mupfdev/TrackMAG/docs/TrackMAG_v1_Prototype_03.jpg

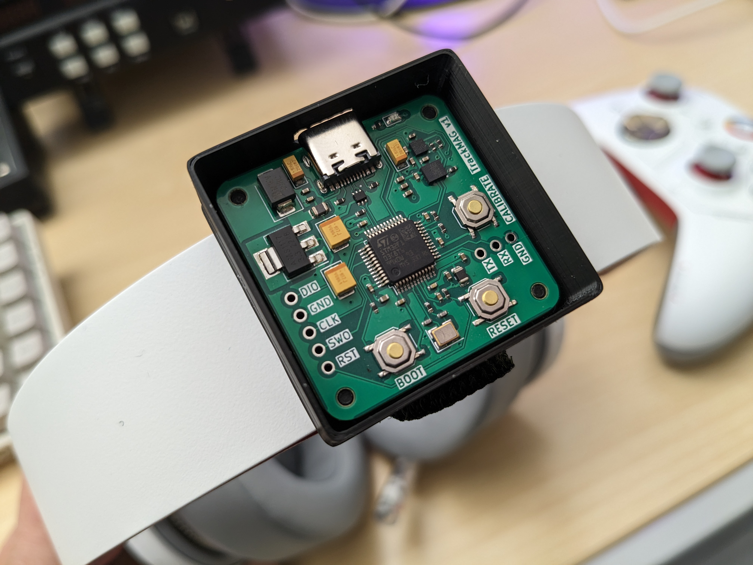
docs/TrackMAG_v1_Prototype_03.jpg
