mupfdev/TrackMAG/docs/TrackMAG_v1_3D.png

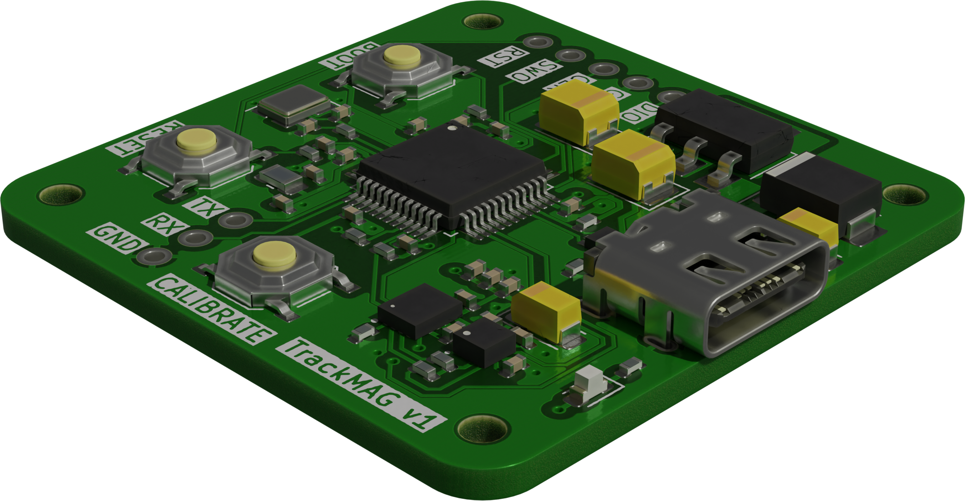
docs/TrackMAG_v1_3D.png
