mupfdev/TrackMAG/docs/serial-oscilloscope.png

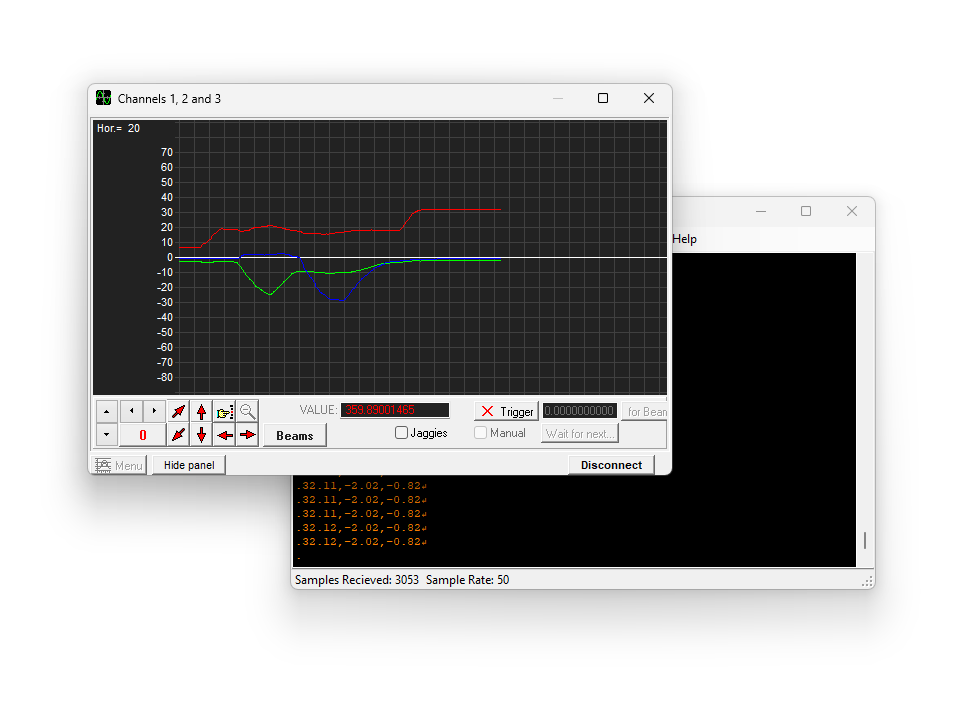
docs/serial-oscilloscope.png
