mupfdev/TrackMAG/docs/TrackMAG_v1_Prototype_01.jpg

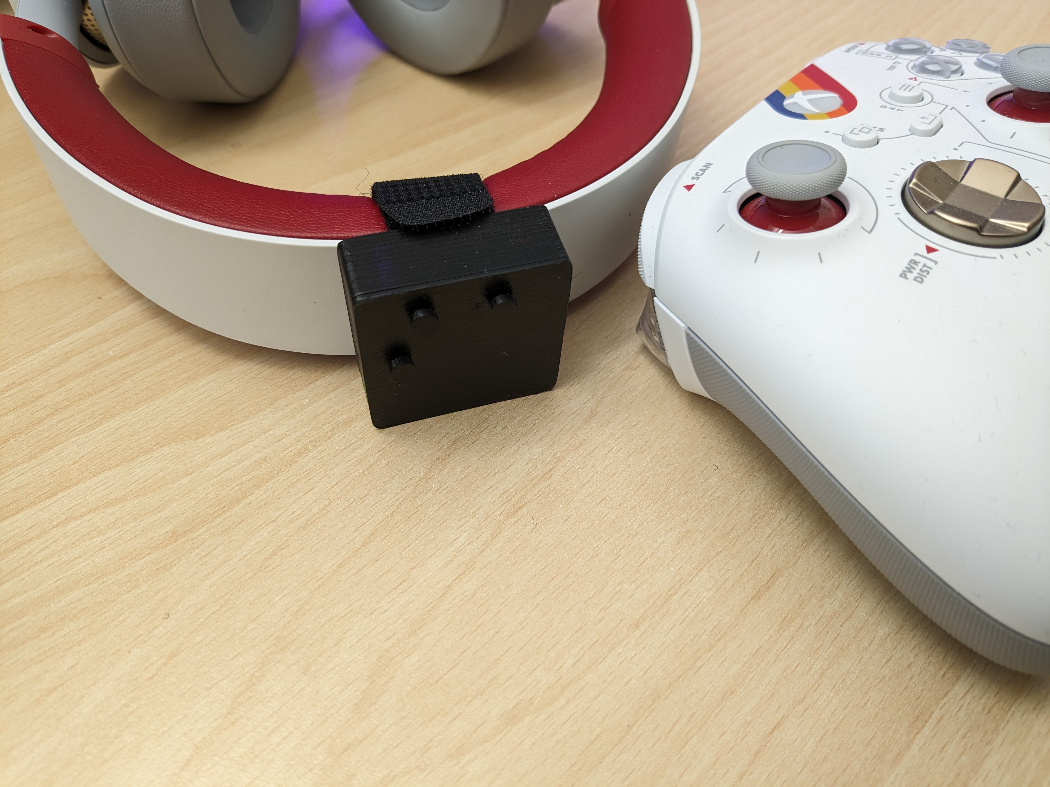
docs/TrackMAG_v1_Prototype_01.jpg
