mupfdev/TrackMAG/docs/TrackMAG_v1_Prototype_02.jpg

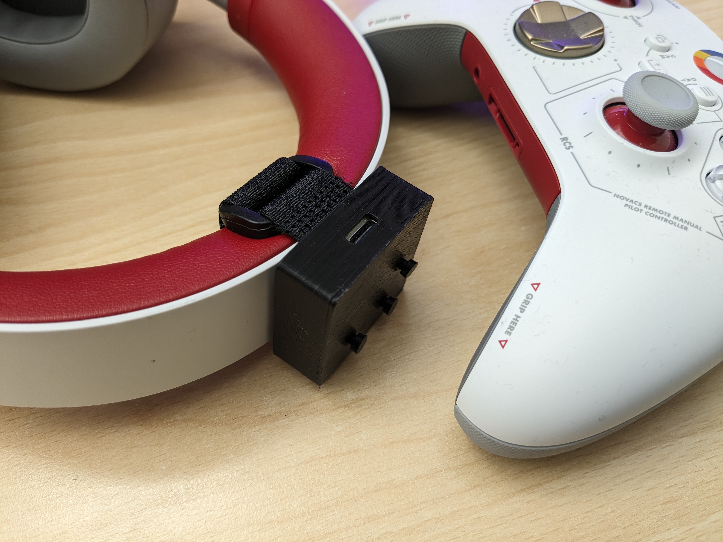
docs/TrackMAG_v1_Prototype_02.jpg
