mupfdev/TrackMAG/cad/TrackMAG_v1_Case.FCStd

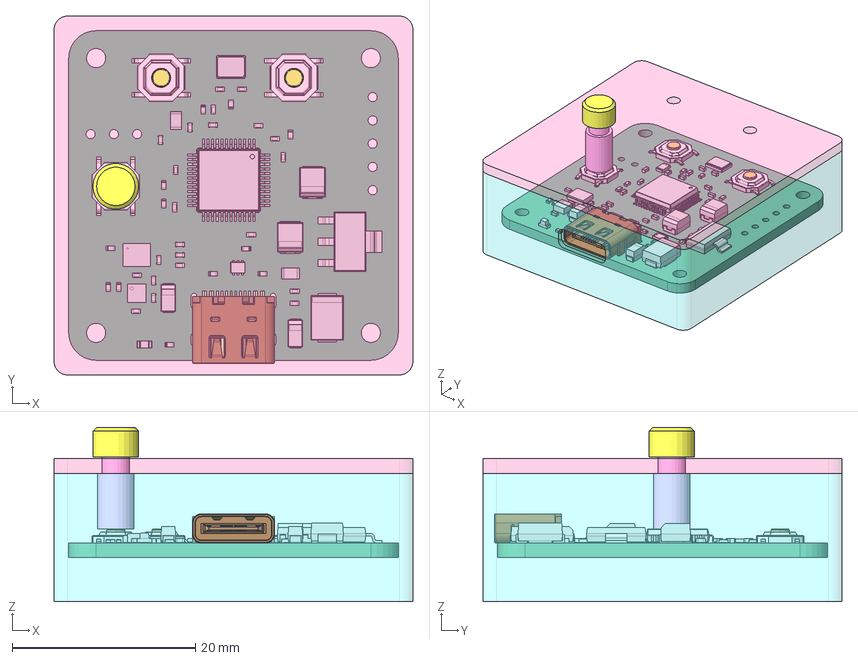
[picture p6: CAD file, 2023-10-26]
cad/TrackMAG_v1_Case.FCStd
39.2 x 39.2 x 19.0 mm
Pcb_d3d2
C5_C_0402_1005Metric_9a69e1afbfc4
U2_SOT_666_c43711e0865f
Y1_Crystal_SMD_3225-4Pin_3.2x2.5mm_c5e00f3d7473
R6_R_0402_1005Metric_10b8d5d8e81b
C4_C_0402_1005Metric_6f371c34e9a7
SW-SMD_4P-L5.2-W5.2-H1.5-LS6.4-P3.071
SW-SMD_4P-L5.2-W5.2-H1.5-LS6.4-P3.70
SW-SMD_4P-L5.2-W5.2-H1.5-LS6.4-P3.072
SW-SMD_4P-L5.2-W5.2-H1.5-LS6.4-P3.073
SW-SMD_4P-L5.2-W5.2-H1.5-LS6.4-P3.074
SW-SMD_4P-L5.2-W5.2-H1.5-LS6.4-P3.075
SW-SMD_4P-L5.2-W5.2-H1.5-LS6.4-P3.076
SW-SMD_4P-L5.2-W5.2-H1.5-LS6.4-P3.077
C24_C_0402_1005Metric_25848f3d0c58
FB2_R_0805_2012Metric_17915c3d4c20
C21_C_0402_1005Metric_c99b34758c5f
C7_C_0402_1005Metric_9be6bc2ca55f
C18_CP_EIA_3216_18_Kemet_A_433f65eda25f
SW-SMD_4P-L5.2-W5.2-H1.5-LS6.4-P3.091
SW-SMD_4P-L5.2-W5.2-H1.5-LS6.4-P3.092
SW-SMD_4P-L5.2-W5.2-H1.5-LS6.4-P3.093
SW-SMD_4P-L5.2-W5.2-H1.5-LS6.4-P3.094
SW-SMD_4P-L5.2-W5.2-H1.5-LS6.4-P3.095
SW-SMD_4P-L5.2-W5.2-H1.5-LS6.4-P3.096
SW-SMD_4P-L5.2-W5.2-H1.5-LS6.4-P3.097
SW-SMD_4P-L5.2-W5.2-H1.5-LS6.4-P3.098
U5_SOT_223_951f59756fd7
R11_R_0402_1005Metric_36e4ea1ddef2
SW-SMD_4P-L5.2-W5.2-H1.5-LS6.4-P3.100
SW-SMD_4P-L5.2-W5.2-H1.5-LS6.4-P3.101
SW-SMD_4P-L5.2-W5.2-H1.5-LS6.4-P3.102
SW-SMD_4P-L5.2-W5.2-H1.5-LS6.4-P3.103
SW-SMD_4P-L5.2-W5.2-H1.5-LS6.4-P3.104
SW-SMD_4P-L5.2-W5.2-H1.5-LS6.4-P3.105
SW-SMD_4P-L5.2-W5.2-H1.5-LS6.4-P3.106
SW-SMD_4P-L5.2-W5.2-H1.5-LS6.4-P3.107
D2_D_SMB_b67b8ca27ae9
D1_LED_0603_1608Metric_e1b3c7ec0367
R5_R_0402_1005Metric_749ad747d199
C22_C_0402_1005Metric_51b8da385749
C13_C_0402_1005Metric_0a9d8d8b6256
C26_CP_EIA_3528_21_Kemet_B_90cebfa39647
R2_R_0402_1005Metric_bf39874a3177
C14_C_0402_1005Metric_74524feb4748
C3_C_0402_1005Metric_b7d28959cc93
C16_C_0402_1005Metric_8a28c750fc0c
C12_C_0402_1005Metric_e2d5079fb1e0
C10_C_0402_1005Metric_4719a34ee131
R9_R_0402_1005Metric_5df443b7ed3e
R12_R_0402_1005Metric_7cb5b9999224
R4_R_0402_1005Metric_2e21d4b728d1
R1_R_0402_1005Metric_d8ff90d443a8
C6_C_0402_1005Metric_24ae957f6994
C19_C_0402_1005Metric_59439e0915fe
C8_CP_EIA_3216_18_Kemet_A_7c873c08f671
C15_C_0402_1005Metric_27ff3f71a5b5
R3_R_0402_1005Metric_e49eb8bdb652
C20_C_0402_1005Metric_27a3aa8959b8
C9_C_0402_1005Metric_0a1977d0a397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
