mupfdev/TrackMAG/(threads)

Thread 3 (2023-11-04):

HID-Device not recognised when started via bootloader

mupfdev, 2023-11-04:
This is not a bug of the bootloader. I'm currently investigating the issue.

mupfdev, 2023-11-04:
The problem was a typo in the FLASH offset inside the linker script. The firmware wasn't working at all.

mupfdev, 2023-11-04:
Fixed.

Closed 2023-11-04.
