mupfdev/TrackMAG/pdf/Schematic.pdf

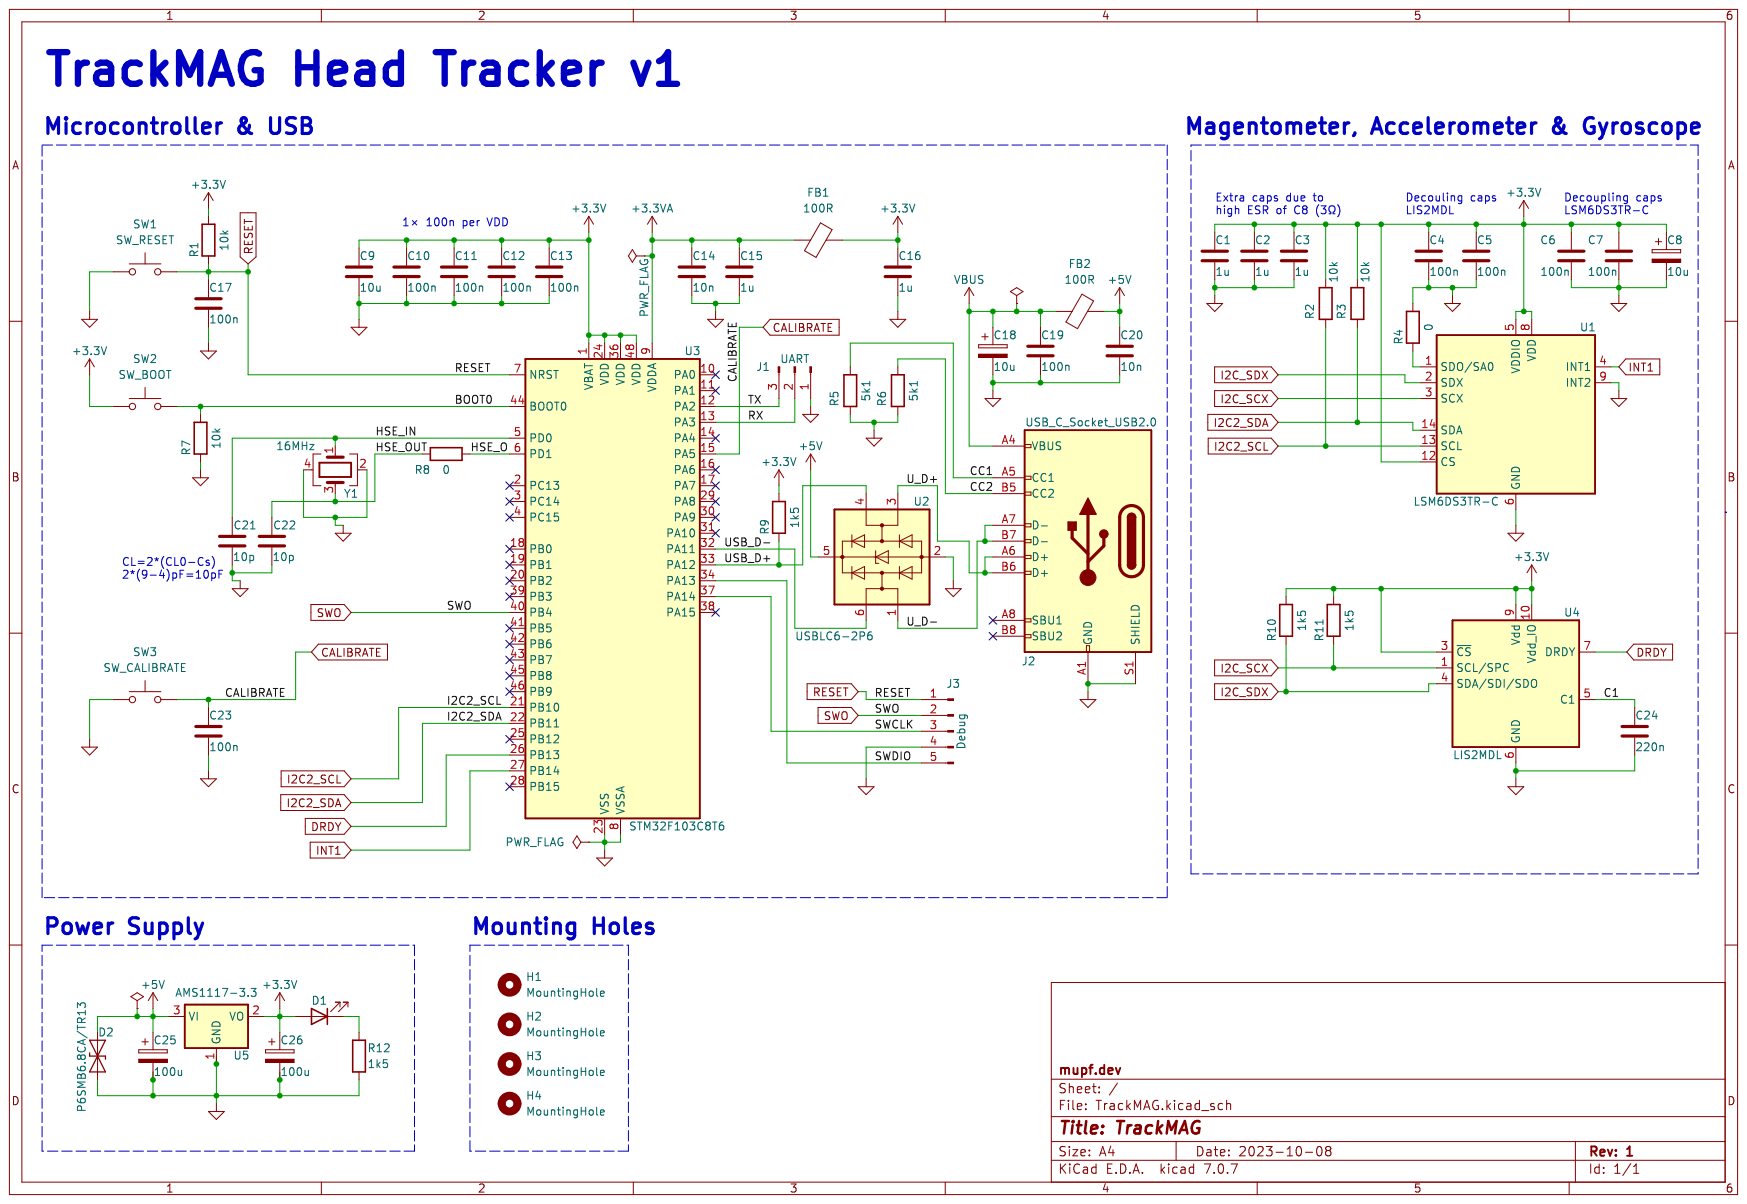
[picture p7: page 1]
