mupfdev/TrackMAG/hardware/TrackMAG.kicad_pcb

## KiCad design hardware/TrackMAG.kicad_pcb (2023-10-11)

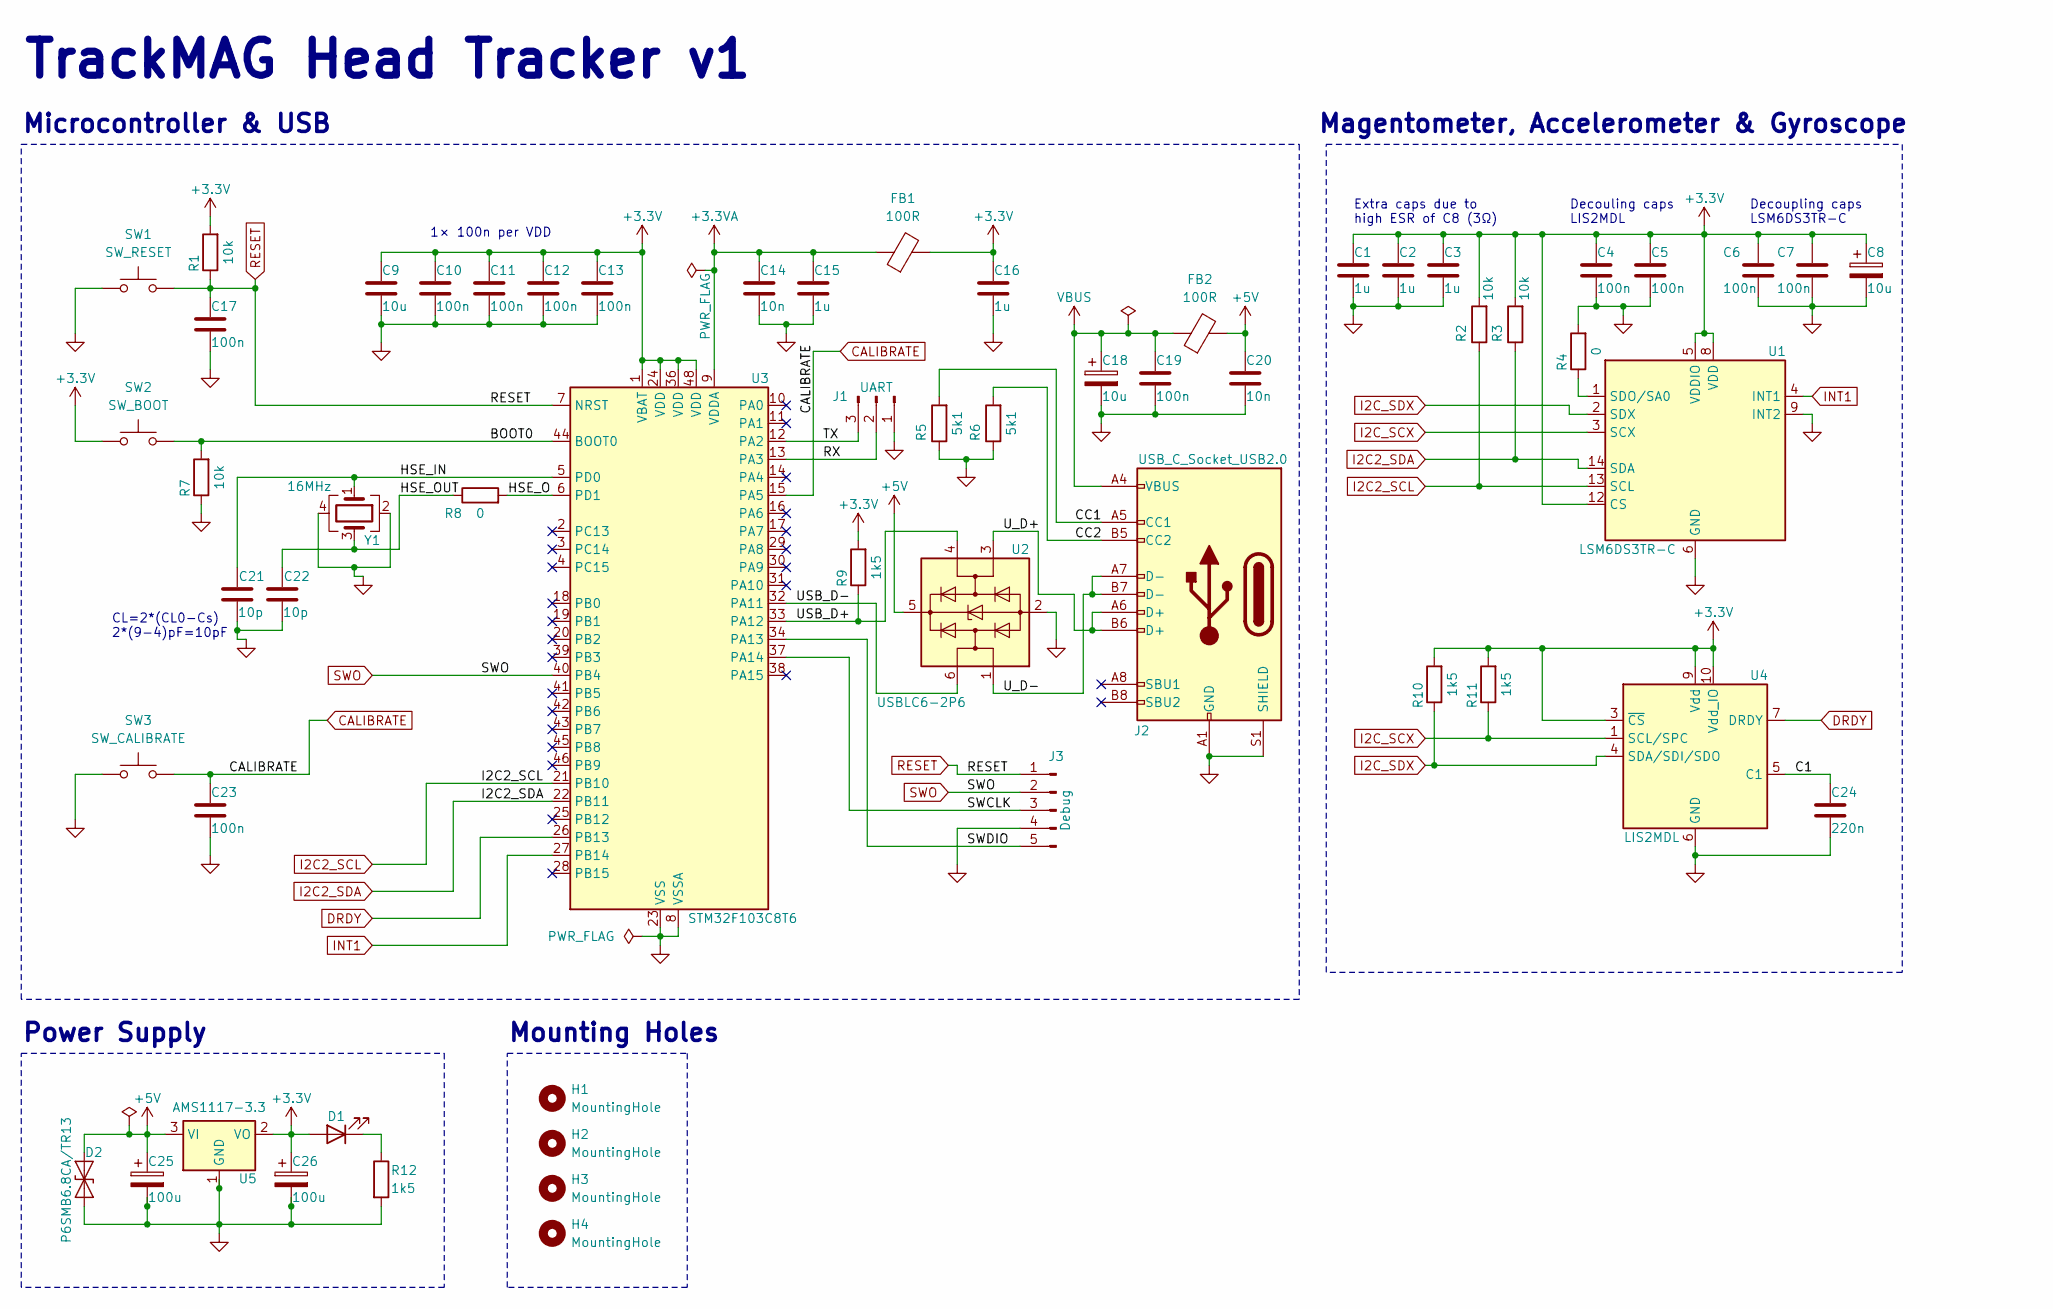
[picture p8: schematic TrackMAG.kicad_sch]

Parts:
C1, C2, C3, C15, C16: 1u; C_0402_1005Metric; JLCPCB Part # C52923
C4, C5, C6, C7, C10, C11, C12, C13, C17, C19, C23: 100n; C_0402_1005Metric; JLCPCB Part # C307331
C8, C18: 10u; CP_EIA-3216-18_Kemet-A; JLCPCB Part # C7171
C9: 10u; C_0402_1005Metric; JLCPCB Part # C15525
C14, C20: 10n; C_0402_1005Metric; JLCPCB Part # C15195
C21, C22: 10p; C_0402_1005Metric; JLCPCB Part # C32949
C24: 220n; C_0402_1005Metric; JLCPCB Part # C16772
C25, C26: 100u; CP_EIA-3528-21_Kemet-B; JLCPCB Part # C16133
D1: LED; LED_0603_1608Metric; JLCPCB Part # C2286
D2: P6SMB6.8CA/TR13; D_SMB; JLCPCB Part # C78395
FB1, FB2: 100R; R_0805_2012Metric; JLCPCB Part # C1015
H1, H2, H3, H4: MountingHole; MountingHole_2.1mm
J1: UART; PinHeader_1x03_P2.54mm_UART
J2: USB_C_Socket_USB2.0; USB_C_Receptacle_G-Switch_GT-USB-7010ASV; JLCPCB Part # C2988369
J3: Debug; PinHeader_1x05_P2.54mm_Debug
R1, R2, R3, R7: 10k; R_0402_1005Metric; JLCPCB Part # C25744
R4, R8: 0; R_0402_1005Metric; JLCPCB Part # C17168
R5, R6: 5k1; R_0402_1005Metric; JLCPCB Part # C25905
R9, R10, R11, R12: 1k5; R_0402_1005Metric; JLCPCB Part # C25867
SW1: SW_RESET; SW_Push_1P1T_XKB_TS-1187A_RESET; JLCPCB Part # C318884
SW2: SW_BOOT; SW_Push_1P1T_XKB_TS-1187A_BOOT; JLCPCB Part # C318884
SW3: SW_CALIBRATE; SW_Push_1P1T_XKB_TS-1187A_CALIBRATE; JLCPCB Part # C318884
U1: LSM6DS3TR-C; LGA-14_3x2.5mm_P0.5mm_LayoutBorder3x4y; JLCPCB Part # C967633
U2: USBLC6-2P6; SOT-666; JLCPCB Part # C2827693
U3: STM32F103C8T6; LQFP-48_7x7mm_P0.5mm; JLCPCB Part # C8734
U4: LIS2MDL; LGA-12_2x2mm_P0.5mm; JLCPCB Part # C919695
U5: AMS1117-3.3; SOT-223-3_TabPin2; JLCPCB Part # C6186
Y1: 16MHz; Crystal_SMD_3225-4Pin_3.2x2.5mm; JLCPCB Part # C13738

Connections:
+3.3V: C1.1, C2.1, C3.1, C4.1, C5.1, C6.1, C7.1, C8.1, C9.1, C10.1, C11.1, C12.1, C13.1, C16.1, C26.1, D1.2 (A), FB1.2, R1.2, R2.2, R3.2, R9.2, R10.2, R11.2, SW2.1, U1.5 (VDDIO), U1.8 (VDD), U1.12 (CS), U3.1 (VBAT), U3.24 (VDD), U3.36 (VDD), U3.48 (VDD), U4.3 (~CS), U4.9 (Vdd), U4.10 (Vdd_IO), U5.2 (VO)
+3.3VA: C14.1, C15.1, FB1.1, U3.9 (VDDA)
+5V: C20.1, C25.1, D2.1 (A1), FB2.2, U2.5 (VBUS), U5.3 (VI)
/BOOT0: R7.2, SW2.2, U3.44 (BOOT0)
/C1: C24.1, U4.5 (C1)
/CC1: J2.A5 (CC1), R5.2
/CC2: J2.B5 (CC2), R6.2
/HSE_IN: C21.1, U3.5 (PD0), Y1.1
/HSE_O: R8.2, U3.6 (PD1)
/HSE_OUT: C22.1, R8.1, Y1.3
/RX: J1.2, U3.13 (PA3)
/SWCLK: J3.3, U3.37 (PA14)
/SWDIO: J3.5, U3.34 (PA13)
/TX: J1.3, U3.12 (PA2)
/USB_D+: R9.1, U2.4 (I/O2), U3.33 (PA12)
/USB_D-: U2.6 (I/O1), U3.32 (PA11)
/U_D+: J2.A6 (D+), J2.B6 (D+), U2.3 (I/O2)
/U_D-: J2.A7 (D-), J2.B7 (D-), U2.1 (I/O1)
CALIBRATE: C23.1, SW3.2, U3.15 (PA5)
DRDY: U3.26 (PB13), U4.7 (DRDY)
GND: C1.2, C2.2, C3.2, C4.2, C5.2, C6.2, C7.2, C8.2, C9.2, C10.2, C11.2, C12.2, C13.2, C14.2, C15.2, C16.2, C17.2, C18.2, C19.2, C20.2, C21.2, C22.2, C23.2, C24.2, C25.2, C26.2, D2.2 (A2), J1.1, J2.A1 (GND), J2.A12 (GND), J2.B1 (GND), J2.B12 (GND), J2.S1 (SHIELD), J3.4, R4.2, R5.1, R6.1, R7.1, R12.2, SW1.1, SW3.1, U1.6 (GND), U1.7 (GND), U1.9 (INT2), U2.2 (GND), U3.8 (VSSA), U3.23 (VSS), U3.35 (VSS), U3.47 (VSS), U4.6 (GND), U4.8 (GND), U5.1 (GND), Y1.2, Y1.4
I2C2_SCL: R2.1, U1.13 (SCL), U3.21 (PB10)
I2C2_SDA: R3.1, U1.14 (SDA), U3.22 (PB11)
I2C_SCX: R11.1, U1.3 (SCX), U4.1 (SCL/SPC)
I2C_SDX: R10.1, U1.2 (SDX), U4.4 (SDA/SDI/SDO)
INT1: U1.4 (INT1), U3.27 (PB14)
unnamed: D1.1 (K), R12.1
unnamed: R4.1, U1.1 (SDO/SA0)
RESET: C17.1, J3.1, R1.1, SW1.2, U3.7 (NRST)
SWO: J3.2, U3.40 (PB4)
VBUS: C18.1, C19.1, FB2.1, J2.A4 (VBUS), J2.A9 (VBUS), J2.B4 (VBUS), J2.B9 (VBUS)

Notes on the sheet:
Microcontroller & USB
Power Supply
TrackMAG Head Tracker v1
1× 100n per VDD
CL=2*(CL0-Cs) 2*(9-4)pF=10pF
Decoupling caps LSM6DS3TR-C
Decouling caps LIS2MDL
Magentometer, Accelerometer & Gyroscope
Mounting Holes
Extra caps due to high ESR of C8 (3Ω)

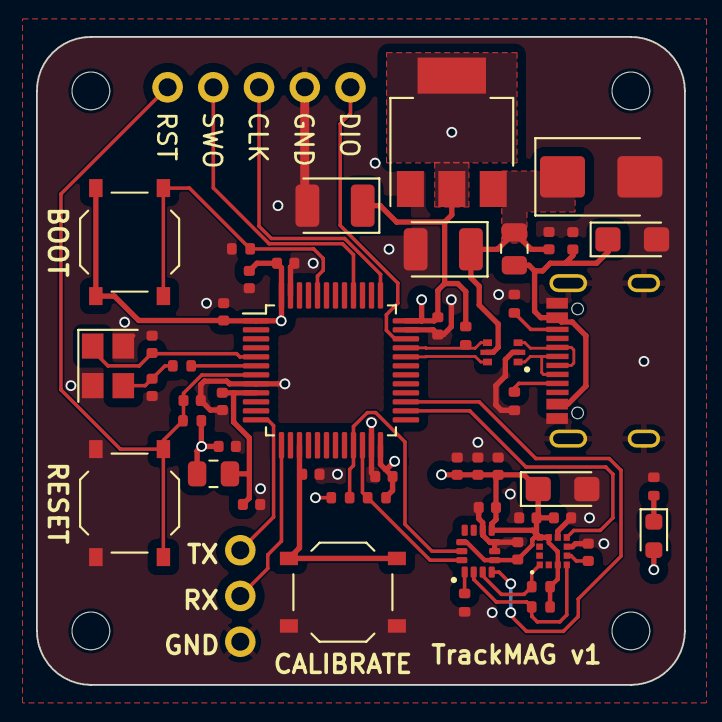
[picture p9: board TrackMAG.kicad_pcb from above]

Board: 4 copper layers, 36.0 x 36.0 mm, 58 parts (0 on the bottom side), 31 nets.
