mupfdev/TrackMAG/firmware/TrackMAG.ioc

Mcu.UserName=STM32F103C8Tx
PA11.Signal=USB_DM
PA12.Signal=USB_DP
PA13.Signal=SYS_JTMS-SWDIO
PA14.Signal=SYS_JTCK-SWCLK
PA2.Signal=USART2_TX
PA3.Signal=USART2_RX
PA5.GPIO_Label=CALIBRATE
PA5.Signal=GPXTI5
PB10.Signal=I2C2_SCL
PB11.Signal=I2C2_SDA
PB13.GPIO_Label=DRDY
PB13.Signal=GPXTI13
PB14.GPIO_Label=INT1
PB14.Signal=GPXTI14
PD0-OSC_IN.Signal=RCC_OSC_IN
PD1-OSC_OUT.Signal=RCC_OSC_OUT
