mupfdev/TrackMAG/firmware/Core/Inc/main.h

#define CALIBRATE_Pin GPIO_PIN_5
#define CALIBRATE_GPIO_Port GPIOA
#define CALIBRATE_EXTI_IRQn EXTI9_5_IRQn
#define DRDY_Pin GPIO_PIN_13
#define DRDY_GPIO_Port GPIOB
#define DRDY_EXTI_IRQn EXTI15_10_IRQn
#define INT1_Pin GPIO_PIN_14
#define INT1_GPIO_Port GPIOB
#define INT1_EXTI_IRQn EXTI15_10_IRQn
