mupfdev/TrackMAG/(commit log)

2023-10-02 Update pinout to match current firmware configuration
    [TrackMAG.kicad_pcb, TrackMAG.kicad_sch]
2023-10-04 Backup current progress
    [TrackMAG.kicad_pcb, TrackMAG.kicad_sch]
2023-10-04 Update schematic to match current progress
2023-10-06 Backup currend KiCAD progress
    [TrackMAG.kicad_pcb, TrackMAG.kicad_sch]
2023-10-06 Add ground planes
    [TrackMAG.kicad_pcb]
2023-10-06 Add missing connections
    [TrackMAG.kicad_pcb, TrackMAG.kicad_sch]
2023-10-06 Add reference vias
    [TrackMAG.kicad_pcb]
2023-10-06 Update schematic PDF and minor PCB cleanup
    [TrackMAG.kicad_pcb, TrackMAG.kicad_sch]
2023-10-06 Center PCB
    [TrackMAG.kicad_pcb]
2023-10-06 Update PDF schematic, add calibrate switch
2023-10-06 Add calibrate switch
    [TrackMAG.kicad_pcb, TrackMAG.kicad_sch]
2023-10-06 Update base firmware configuration to match current hardware setup
2023-10-07 Fix various problems, cleanup after review
    [TrackMAG.kicad_pcb, TrackMAG.kicad_sch]
2023-10-07 Minor cleanup
    [TrackMAG.kicad_pcb]
2023-10-07 Remove redundant connection on PB0
    [TrackMAG.kicad_pcb, TrackMAG.kicad_sch]
2023-10-07 Remove redundant vias, adjust reference vias
    [TrackMAG.kicad_pcb]
2023-10-07 Optimize PCB layout
    [TrackMAG.kicad_pcb, TrackMAG.kicad_sch]
2023-10-07 Increase spacing of INT1 line
    [TrackMAG.kicad_pcb]
2023-10-08 Remove UART pin header from position files
    [TrackMAG.kicad_pcb, TrackMAG.kicad_sch]
2023-10-08 Hide pin header 3D models
    [TrackMAG.kicad_pcb]
2023-10-08 Final cleanup v1
    [TrackMAG.kicad_pcb]
2023-10-08 Add v1 production files used for JLCPCB order
    [bom.csv, designators.csv, positions.csv]
2023-10-11 Minor cleanup, adjust wrong symbol in schematic and adjust TV footprint on PCB
    [TrackMAG.kicad_pcb, TrackMAG.kicad_sch]
2023-10-11 Add work-in-progress project case
    [TrackMAG_v1_Case.FCStd]
2023-10-12 Add yet unfinished TrackMAG case to GitHub pages
2023-10-12 Update yet unfinished case 3D model
    [TrackMAG_v1_Case.FCStd]
2023-10-13 Recreate yet-unfinished case design, lid and snap-fit joint
    [TrackMAG_v1_Case.FCStd]
2023-10-14 Replace snap-fit with simpler press-fit design
    [TrackMAG_v1_Case.FCStd]
2023-10-14 Add yet untested twist-lock for headset mount
    [TrackMAG_v1_Case.FCStd]
2023-10-15 Update mount material for better visibility
    [TrackMAG_v1_Case.FCStd]
2023-10-16 Add schematic to project website
2023-10-18 Add 3D rendering of PCB
2023-10-18 Update case
    [TrackMAG_v1_Case.FCStd]
2023-10-18 Just making sure everything is up to date
    [TrackMAG_v1_Case.FCStd]
2023-10-19 Optimise case, add buttons
    [TrackMAG_v1_Case.FCStd]
2023-10-19 Adjust bootloader vid/pid, update clock configuration to use 16MHz oscillator
    [main.c]
2023-10-19 Cosmetic changes, remove redundant button
2023-10-20 Update index.html: hide Detach DFU button
2023-10-20 Add buttons, minor modifications on case
    [TrackMAG_v1_Case.FCStd]
2023-10-20 Rework case to be able to strap it to a headset without the optional twist lock mechanism
    [TrackMAG_v1_Case.FCStd]
2023-10-20 Add prototype image
2023-10-20 Add updated model
    [TrackMAG_v1_Case.FCStd]
2023-10-20 Add contents link to prototype section
2023-10-20 Prototype: make background transparent
2023-10-20 Replace prototype image because it looks weird, add 3 new images
2023-10-22 Poll sensor data
2023-10-26 Add basic filtering, implement pitch
2023-10-29 Rewrite MAG handler, initialise sensors from scratch, yet unfinished because the calculated yaw axis (MotionFX) seems extremely unstable.
    [TrackMAG.ioc, mag_handler.c, main.c]
2023-10-30 Apply filter chain
2023-10-30 Disable automatic gbias calculation, calibration only
2023-10-30 Add slightly adjusted linker scripts, setup MotionFX properly - works now, add calibration feature
2023-10-31 Save calibration data to flash, load it on bootup
2023-10-31 Fix typo, adjust workflow to only run when the firmware code has been updated
    [mag_handler.c]
2023-10-31 Fix path in workflow
    [mag_handler.c]
2023-10-31 Output orientation string via UART
2023-11-01 Use 0 for default calibration when stored value is not a number, eg when flash is empty
2023-11-01 Drop polling, use interrupts
2023-11-03 Rename function to avoid confusion
    [main.c]
2023-11-04 Update debug/launch configurations to use upper flash bank (which isn't officially supported)
    [stm32f1x_128k.cfg]
2023-11-09 Add additional build config, add x axis transformation
